fablabromagna-org/Conta-Spara/docs/images/485_test_arduino.jpg

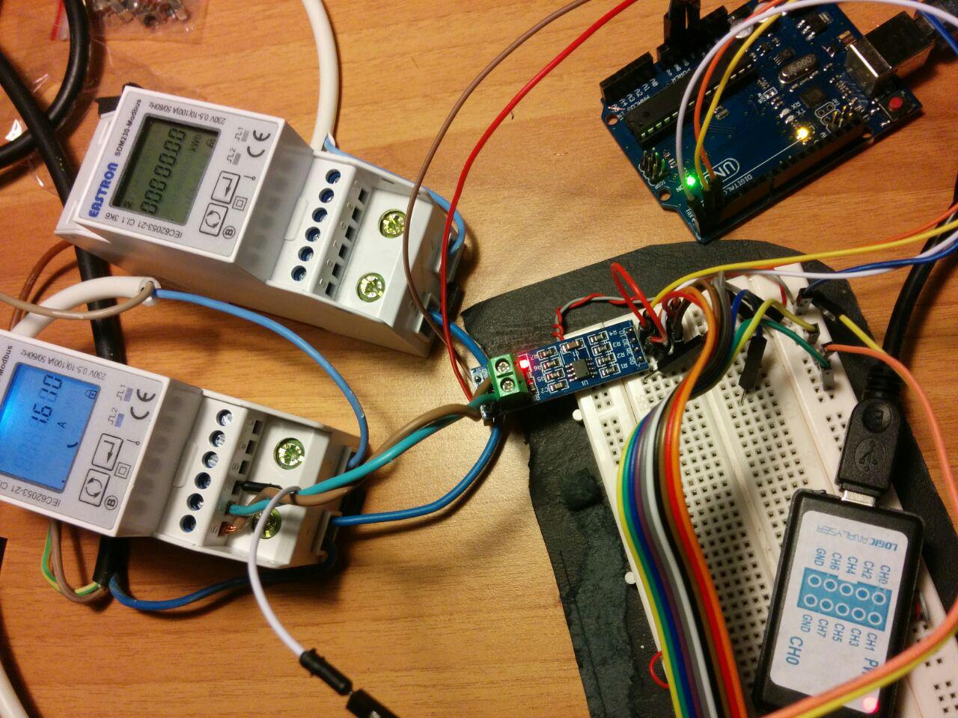
docs/images/485_test_arduino.jpg
