fablabromagna-org/Conta-Spara/docs/images/primabasetta.png

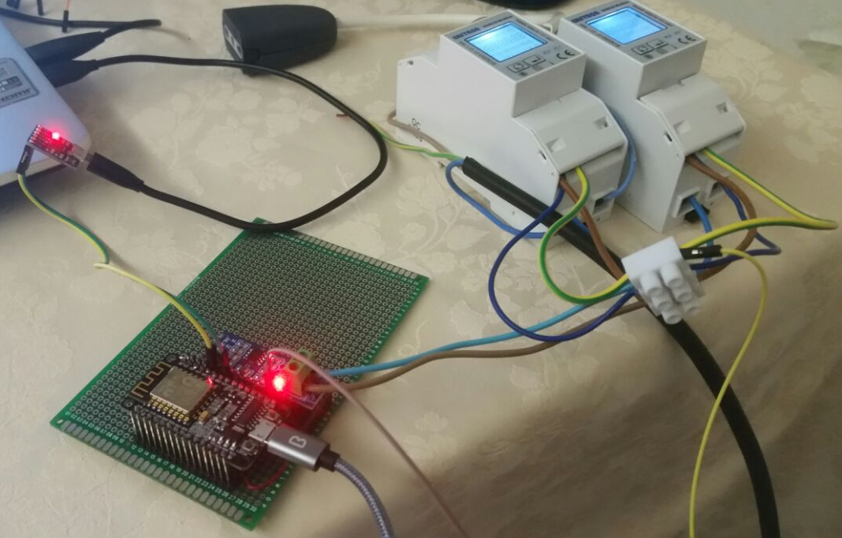
docs/images/primabasetta.png
