fablabromagna-org/Conta-Spara/README.md

# Conta-Spara
Misurazione consumi, ottimizzazione fonti e gestione carichi elettrici.

## Descrizione
Da una esigenza di Gianpaolo Missiroli, si vuol realizzare un sistema in grado di rilevare i consumi di una palazzina con 6 appartamenti (di cui 4 estivi), modificare la modalità di funzionamento del sistema fotovoltaico con accumulo e intervenire sul funzionamento dei carichi di ogni singolo appartamento collegandoli o scollegandoli in base alle necessità/priorità.

Per le informazioni di dettaglio consultate il [wiki del progetto](https://github.com/fablabromagna-org/Conta-Spara/wiki)

## Riferimenti
https://trello.com/c/ux4akqBq/3-contaspara-misurazione-consumi-ottimizzazione-fonti-e-gestione-carichi-elettrici

## Risorse e link esterni

## Team:
* Gianpaolo Missiroli (GpMissi)
* Ivan Tarozzi  (itarozzi)
