fablabromagna-org/Conta-Spara/node-red/README.md

Node-RED Flows per Conta&Spara
==============================

Questa cartella contiene i JSON corrispondenti ai flows di Node-RED.

Node-RED viene utilizzato sia in produzione che per funzioanlita' di test e verifica
