fablabromagna-org/Conta-Spara/docs/images/modbus_rs485.png

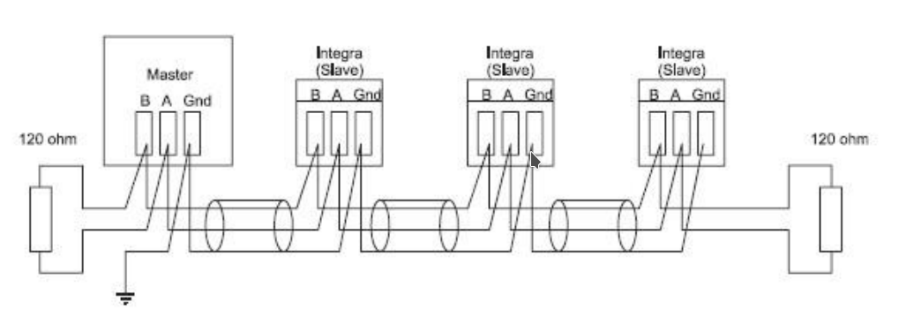
docs/images/modbus_rs485.png
