fablabromagna-org/Conta-Spara/docs/images/SDM230Sketch_bb.png

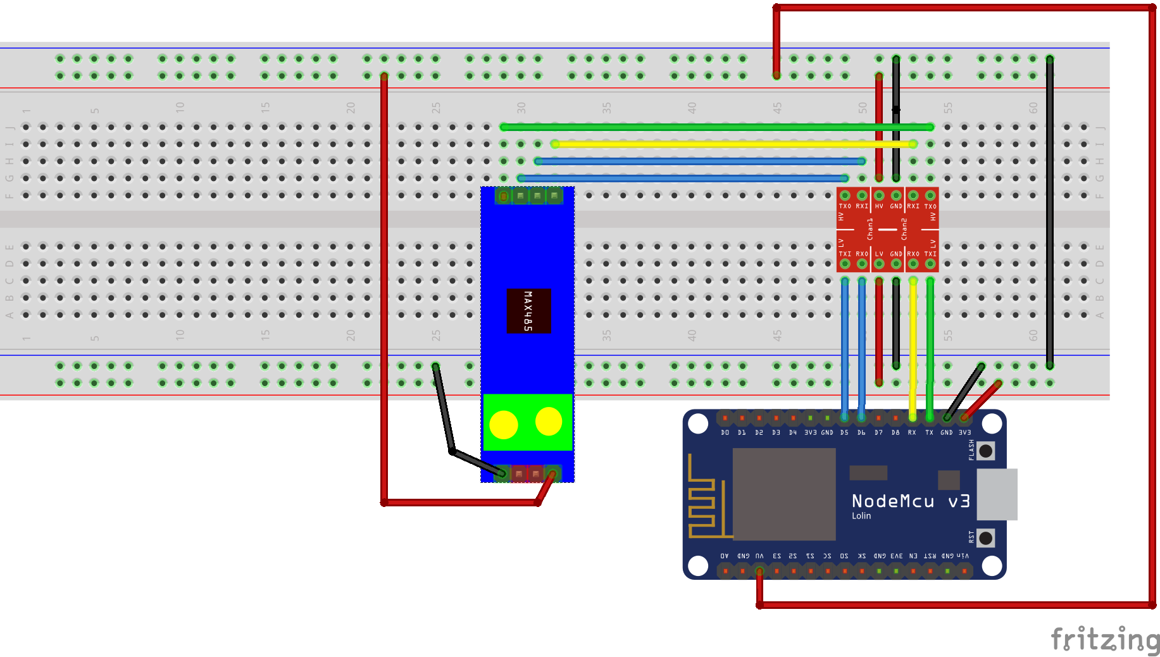
docs/images/SDM230Sketch_bb.png
