fablabromagna-org/Conta-Spara/(threads)

Thread 1 (2017-12-06):

Fare test interfacciamento SDM230 - PI via NodeBus

itarozzi, 2017-12-06:
I moduli comunicano via Modbus (RS-485) quindi occorre un convertitore lato PC/Raspberry.

Verificare se Node-RED dispone già di un modo per interrogare dispositivi via modbus

itarozzi, 2017-12-06:
@GPMissi: dare interfaccia RS485 a Ivan x test e affiancarlo ...

itarozzi, 2017-12-21:
Gestire per il momento nr 7 misuratori
- 1 generale
- 5 appartamenti
- 1 servizi

Utilizzare ESP8266 per lettura ModBus da 485 e pubblicare i valori su MQTT
Attenzione alla traslazione dei livelli TTL della seriale da 5v a 3v3

Thread 2 (2017-12-06):

OCR Display

itarozzi, 2017-12-06:
Verificare la possibilità di riconoscere le immagini (e quindi il contenuto alfanumerico) del dispay di un inverter tramite webcam collegata al RaspberryPI

GpMissi, 2017-12-27:
Mi salvo questo link di una applicazione che potrebbe essere utile (forse) come sistema di acquisizione delle immagini dalla CAM: https://elinux.org/RPi-Cam-Web-Interface

Thread 3 (2017-12-06):

Realizzazione parte meccanica "multi attuatore lineare" a 4 dita

itarozzi, 2017-12-06:

GpMissi, 2017-12-25:
Per questa parte del progetto si pensa di usare dei SERVO SG90 pilotati direttamente dalla Raspberry PI 3 che contiene la logica applicativa su come devono essere effettuati i settaggi e che sarà in grado di "leggere" il display dell'inverter.
Si pensa di usare NODE-RED come ambiente di sviluppo e quindi i test iniziano usando i nodi standard RPI GPIO (ma con risultati molto scadenti), per poi passare ai nodi PI GPIOD qui documentati: https://flows.nodered.org/node/node-red-node-pi-gpiod ottenendo un buon funzionamento.

Thread 4 (2017-12-15):

Problema disturbo su seriale con alimentatore switching del notebook collegato

itarozzi, 2017-12-15:
Segnalo un problema riscontrato durante i test di comunicazione modbus con i misuratori SDM230 su RS485.

Il sistema di test è quella in [Immagine 1](https://github.com/fablabromagna-org/Conta-Spara/blob/master/docs/images/485_test_arduino.jpg)

## Descrizione
In questa primissima fase di test sto cercando di verificare il corretto funzionamento del cablaggio, del convertitore RS-485 - TTL e dei messaggi Modbus utili a leggere le informazioni energetiche,

Per semplificare sto usando un Arduino UNO, visto che ci sono diversi esempi già pronti.

Lo schema di collegamento prevede:

- convertitore 485-TTL collegato ai misuratori attraverso una coppia 485  (A-B)  *
- convertitore alimentato da Arduino (5V + GND)
- convertitore pilotato da Arduino attraverso TX, RX, pin DE e pin RE (questi ultimi entrambi su PIN2)
- arduino collegato al PC e verifica dei dati ricevuti tramite monitor seriale

In questa situazione tutto sembra funziona **a patto che il notebook non sia connesso alla rete elettrica**.  Collegando il notebook all'alimentatore si iniziano a ricevere una serie di disturbi sul pin RX che causano problemi al corretto funzionamento del sistema.

Il disturbo scompare se
- si scollega il notebook
- si scollega il convertitore da Arduino
- si scollega il bus 485, pur mantenendo il convertitore collegato ad arduino
- si collega la massa lato convertitore alla massa di arduino (cosa che andrebbe comunque fatta)

## Note e workaround

La soluzione migliore consiste nel collegare la massa dei misuratori, cosa che in un reale cablaggio 485 andrebbe fatta utilizzando la calza di schermatura.

La cosa strana è che il problema si presenta solo collegando il notebook a cui è collegato arduino alla rete elettrica.

Evidentemente esiste una interferenza di qualche tipo che si origina solo in determinate condizioni.
Non essendo gli apparati (notebook e misuratori) dotati di cavo di terra, tenderei ad escludere loop di terra.

Se qualcuno avesse delucidazioni commenti pure sotto
