fablabromagna-org/Conta-Spara/(commit log)

2017-12-26 aggiunto prima versione dello sketch per la lettura dei misuratori via ESP8266
2017-12-27 completato primo esempio funzionante di interrogazione misuratori modbus e pubblicazione dati via mqtt
2018-01-20 modificato pin di controllo per convertitore 458, perchè con i precedenti il modulo ESP8266 da problemi di collegamento al wifi... da indagare
    [SDM230_RS485_master_esp8266.ino]
2018-01-30 Prima scheda da mettere in produzione!
    Ecco la prima scheda contenente la NodeMCU, il convertitore di livelli e l'interfaccia RS485
2018-06-19 gestione di 7 misuratori, con indice Modbus definito su array
2018-08-11 aggiunta di nuovi valori per ogni misuratore e revisione topic
